TheRaelNoisyBoi/DIY-HOTAS-Ecosystem/BOM/Rudder Pedals.csv

Category | Component | Quantity | Purchase Link
Hardware | M3x8 mm or M3x10 mm Self-tapping screw | Yes | aliexpress.com/item/1005003330377202.html
Hardware | M3x16 mm Self-tapping screw | Yes | aliexpress.com/item/1005003330377202.html
Hardware | M4x16 mm Self-tapping screw | Yes
Hardware | M2.5x6 mm Self-tapping screw | Yes | aliexpress.com/item/1005003330377202.html
Hardware | 608 Bearing | TBD
Hardware | KFL08 Flange bearing | TBD
Hardware | SI 5TK Rod end bearing | TBD
Hardware | M8 (or 5/16) Threaded rod | TBD
Hardware | M5x60 mm Threaded rod | TBD
Hardware | M5x25 mm Bolt | TBD | aliexpress.com/item/10000183209605.html
Hardware | M5x35 mm Bolt | TBD | aliexpress.com/item/10000183209605.html
Hardware | M8 (or 5/16) Nut | TBD
Hardware | M5 Nut | TBD | aliexpress.com/item/32977174437.html
Hardware | 30mm Tension spring (OD 7-8mm, wire 1.2-1.5mm) | Yes | aliexpress.com/item/1005003298102282.html
Hardware | 30mm Tension spring (OD 5mm, wire 0.8mm) | Yes | aliexpress.com/item/1005003298102282.html
Electronics | Arduino Pro Micro USB C | 1 | aliexpress.com/item/1348800135.html
Electronics | SS49E Hall effect sensor | 3 | aliexpress.com/item/32947585715.html
Electronics | 5x2mm Axial magnet | 4 | aliexpress.com/item/1005010075039991.html
Electronics | 10x5mm Axial magnet | 1 | aliexpress.com/item/1005010075211239.html
